bristol-communal-modular/state-variable-filter/fixes.md

# Fixes

## Rev 01

* On all four of the filter output jacks, remove the switch for the tip connection. Otherwise the outputs connect to ground through the 330r resistor.
* Add a 47k resistor to ground and the PING jack
* Add two 5pF ceramic C0G capacitors, one in parallel with R28 and one in parallel with R29.
