bristol-communal-modular/state-variable-filter/design/2164-filter.pdf

# Ouroboros 2164 Gain Cell Filter

Guy John
guy@rumblesan.com

December 13, 2025

## 1 Introduction

Analysis of the Ouroboros filter. Heavily based on the Mutable Instruments Blades filter with influences from the Serge VCFQ as well. Much of this analysis is pulled from the SSM2164 SVF Analysis by Emilie Gillet and then just somewhat modified.

1

### 1.1 Notations

Rm is the value of the resistor at the input of the mixer section.

Ri

is the value of the resistors in the input to the 2164 integrator cells.

Rhp is the value of the resistor through which the HP output is fed back into the input mixer.

Rbp is the value of the resistor through which the BP output is fed back into the input mixer.

Rlp is the value of the resistor through which the LP output is fed back into the input mixer.

Rq is the value of the resistor at the input of the gain cell feeding the BP output back to control the Q of the filter.

C is the value of the integrators’ capacitors.

vcv is the cutoff frequency control voltage.

vq is the resonance control voltage.

vi

is the input voltage.

vhp(s), vbp(s) and vlp(s) are the high-pass, band-pass and low-pass output voltages.

For reference, the standard second-order filter transfer functions are:

Hlp(s) = | 1
τ

2s

| 2 +
| 1 q
τs + 1
Hbp(s) = | 1

q
| τ s + qτs + 1
Hhp(s) = | 1

1
τ

2s

| 2 +

1
| qτ s + 1

Where τ =

1
2πC

2

1.2 2164 Integrator Cell

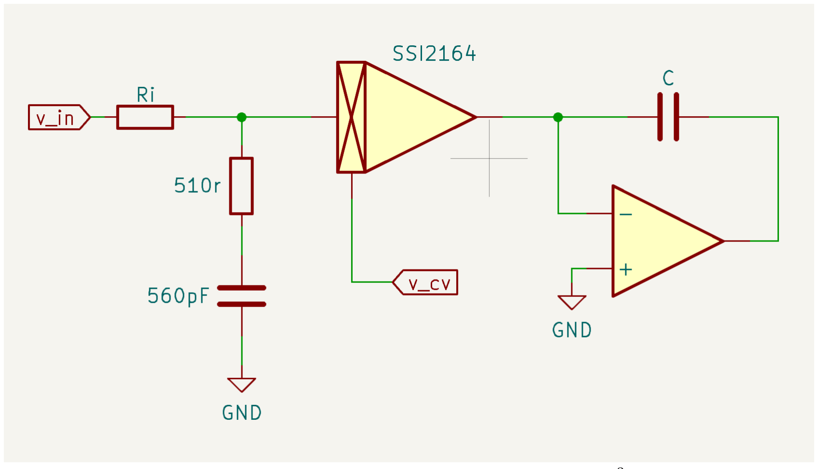
[picture p4: figure]

The current gain of a 2164 gain cell is iout = iin10⁻ ³
2

vcv . The transfer
function of the integrator cell α can then be calculated.

iin =

vin
Ri

iout =

vin
Ri

10⁻ ³
2

vcv

vout = −

iout
Cs

vout = −

vin
Ri

10⁻ ³
2

vcv

Cs

= −

vin10⁻ ³
2

vcv
CsRi
α(s) = vout

vin

= −

1
CsRi

10⁻ ³
2

vcv

3

### 1.3 Resonance VCA

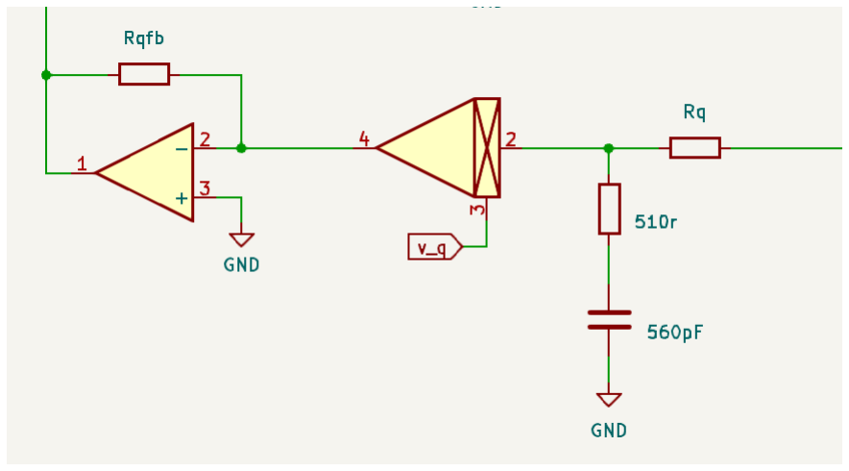
[picture p5: figure]

The transfer function of the resonance feedback VCA β can then be calculated.

iin =

vin
Rq

iout =

vin
Rq

10⁻ ³
2

vq

vout = −ioutRqf b

vout = −

vinRqf b
Rq

10⁻ ³
2

vq

β(s) = vout

vin

= −

Rqf b
Rq

10⁻ ³
2

vq

4

### 1.4 Filter


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
### 1.4.1 High-pass

vhp(s)

Rhp

= −

vi(s)
Ri

−

βvbp(s)

Rbp

−

vlp(s)

Rlp
vhp(s)

Rhp

= −

vi(s)
Ri

−

βα(s)vhp(s)

Rbp

−

α

2
(s)vhp(s)

Rlp
vi(s)
Ri

= −

vhp(s)

Rhp

−

βα(s)vhp(s)

Rbp

−

α

2
(s)vhp(s)

Rlp
vi(s)
Ri

= −vhp(s)( 1

Rhp

+

βα(s)

Rbp

+

α

2
(s)

Rlp

)

vi(s)
vhp(s)

= −Ri(

1

Rhp

+

βα(s)

Rbp

+

α

2
(s)

Rlp

)

Hhp(s) = vhp(s)
vi(s)

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
βα(s)

Rbp

+

α²(s)

Rlp

)

Rhp = Rbp = Rlp = R

= −

1
Ri

1
(

1
R +

βα(s)
R +

α²(s)
R

)

= −

R
Ri
1 + βα(s) + α²(s)

G =

R
Ri

is the pass-band gain.

6

### 1.4.2 Low-Pass

Hlp(s) = vlp(s)
vi(s)

=

vhp(s)
vi(s)

α

2
(s)

= −

R
Ri
1
α²(s) + β

1
α(s) + 1

= −

R
Ri
1
α²(s) + β

1
α(s) + 1

= −

R
Ri
1
(− 1
CsRi

10⁻ ³
2

vcv )

2 + (−

Rqfb
Rq

10⁻ ³
2

vq )

1
− 1
CsRi

10⁻ ³
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
CsRi

10⁻ ³
2

vcv )

2 + ( Rqfb
Rq

10⁻ ³
2

vq )

1

1
CsRi

10⁻ ³
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
10⁻ ³
2

vcv )

2 + ( Rqfb
Rq

10⁻ ³
2

vq )

1

1
s

1
CRi

10⁻ ³
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
10⁻ ³
2

vcv )

2 + ( Rqfb
Rq

10⁻ ³
2

vq )

1

1
s

1
CRi

10⁻ ³
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
10⁻ ³
2

vcv )

2 + ( Rqfb
Rq

10⁻ ³
2

vq )

s

1
CRi

10⁻ ³
2

vcv

+ 1

By comparing with the standard form of a second order filter transfer function we can work out the following.

Pass-band gain, −

R
Ri

Cutoff frequency, f =

1
2πRiC

10⁻ ³
2

vcv

Quality factor, Rq

Rqfb

10 ³
2

vq

### 1.5 Calculating cutoff frequencies

Given the calculation for frequency, and picking some standard values we can calculate cutoff for different icv values.

Ri

is 33k

C is 220pF

7

f =

1
2π ∗ 33000 ∗ 220 ∗ 10⁻¹² 10⁻ ³
2
vcv | (1)

for vcv of 0V f = 21922Hz

for vcv of 0.25V f = 9244Hz

for vcv of 0.5V f = 3898Hz

for vcv of 1V f = 693Hz

for vcv of 2V f = 21Hz

for vcv of 3V f = 0.69Hz

### 1.6 Calculating resonance

A quality factor of 1/2 gives no resonance, whilst the resonance (and likelihood of self oscillating) increases as Q goes to infinity.
Assuming that Rq

Rqfb

= 1/2

Rq is 15k

Rqf b is 30k

q =

15000
30000

10

3/2 vq
(2)

for vq of 0.0V q = 0.5

for vq of 0.25V q = 1.18

for vq of 0.5V q = 2.811

for vq of 1V q = 15.8

for vq of 2V q = 500

8
