bristol-communal-modular/state-variable-filter/kicad/state-variable-filter.kicad_pcb

## KiCad design kicad/state-variable-filter.kicad_pcb (2026-03-02)

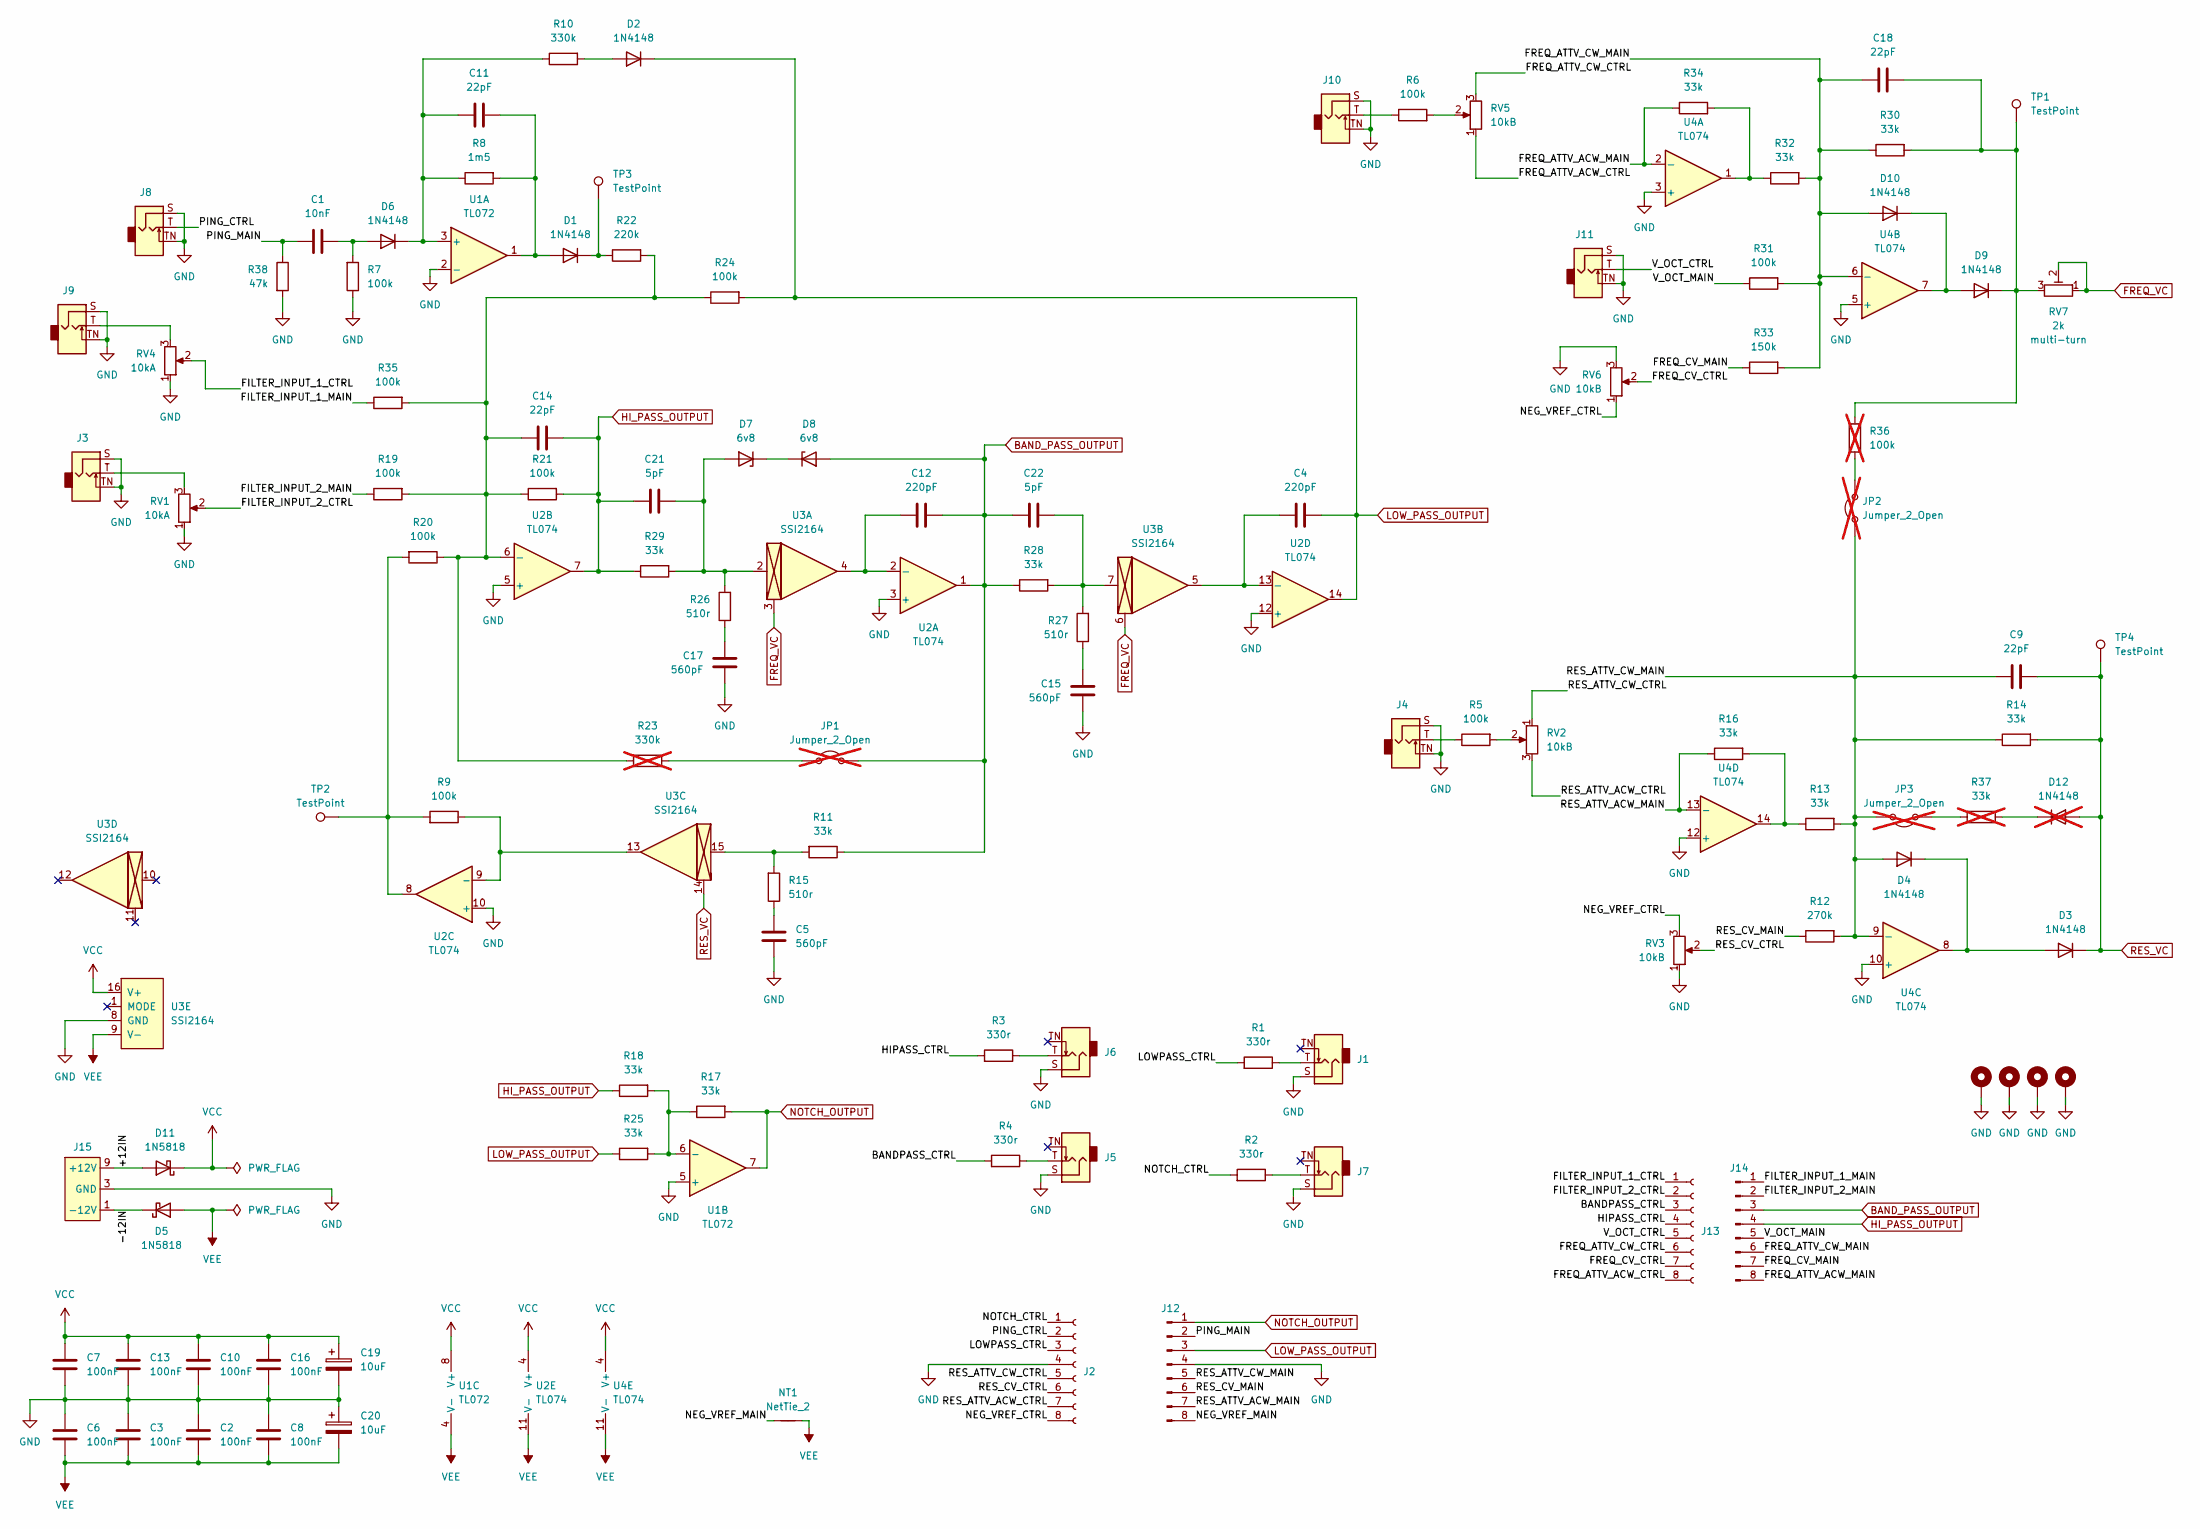
[picture p6: schematic state-variable-filter.kicad_sch, 2164 State Variable Filter]

Parts:
C1: 10nF; C_Rect_L7.0mm_W2.5mm_P5.00mm; Tolerance 5%
C2, C3, C6, C7, C8, C10, C13, C16: 100nF; C_Rect_L7.0mm_W2.5mm_P5.00mm; Tolerance 5%
C4, C12: 220pF; C_Rect_L7.0mm_W4.5mm_P5.00mm; Tolerance 1%
C5, C15, C17: 560pF; C_Rect_L7.0mm_W2.5mm_P5.00mm; Tolerance 5%
C9, C11, C14, C18: 22pF; C_Rect_L7.0mm_W2.5mm_P5.00mm; Tolerance 5%
C19, C20: 10uF; CP_Radial_D5.0mm_P2.00mm
C21, C22: 5pF; C_Rect_L7.0mm_W2.5mm_P5.00mm; Tolerance 5%
D1, D2, D3, D4, D6, D9, D10: 1N4148; D_DO-35_SOD27_P7.62mm_Horizontal
D5, D11: 1N5818; D_DO-41_SOD81_P10.16mm_Horizontal
D7, D8: 6v8; D_DO-35_SOD27_P7.62mm_Horizontal
D12: 1N4148; D_DO-35_SOD27_P7.62mm_Horizontal; not fitted
H1, H2, H3, H4: MountingHole_Pad; MountingHole_3.2mm_M3_DIN965_Pad
J1, J3, J4, J5, J6, J7, J8, J9, J10, J11: AudioJack2_SwitchT; Jack_3.5mm_QingPu_WQP-PJ398SM_Vertical
J2, J13: Conn_01x08_Socket; PinSocket_1x08_P2.54mm_Vertical
J12, J14: Conn_01x08_Pin; PinHeader_1x08_P2.54mm_Vertical
J15: Conn_02x05_Odd_Even; Eurorack_Power_IDC-Header_2x05_P2.54mm_Vertical
JP1, JP2, JP3: Jumper_2_Open; PinHeader_1x02_P2.54mm_Vertical; not fitted
NT1: NetTie_2; NetTie-2_SMD_Pad0.5mm
R1, R2, R3, R4: 330r; R_Axial_DIN0207_L6.3mm_D2.5mm_P10.16mm_Horizontal; Tolerance 1%
R5, R6, R7, R9, R19, R20, R21, R24, R31, R35: 100k; R_Axial_DIN0207_L6.3mm_D2.5mm_P10.16mm_Horizontal; Tolerance 1%
R8: 1m5; R_Axial_DIN0207_L6.3mm_D2.5mm_P10.16mm_Horizontal; Tolerance 1%
R10: 330k; R_Axial_DIN0207_L6.3mm_D2.5mm_P10.16mm_Horizontal; Tolerance 1%
R11, R13, R14, R16, R17, R18, R25, R28, R29, R30, R32, R34: 33k; R_Axial_DIN0207_L6.3mm_D2.5mm_P10.16mm_Horizontal; Tolerance 1%
R12: 270k; R_Axial_DIN0207_L6.3mm_D2.5mm_P10.16mm_Horizontal; Tolerance 1%
R15, R26, R27: 510r; R_Axial_DIN0207_L6.3mm_D2.5mm_P10.16mm_Horizontal; Tolerance 1%
R22: 220k; R_Axial_DIN0207_L6.3mm_D2.5mm_P10.16mm_Horizontal; Tolerance 1%
R23: 330k; R_Axial_DIN0207_L6.3mm_D2.5mm_P10.16mm_Horizontal; Tolerance 1%; not fitted
R33: 150k; R_Axial_DIN0207_L6.3mm_D2.5mm_P10.16mm_Horizontal; Tolerance 1%
R36: 100k; R_Axial_DIN0207_L6.3mm_D2.5mm_P10.16mm_Horizontal; Tolerance 1%; not fitted
R37: 33k; R_Axial_DIN0207_L6.3mm_D2.5mm_P10.16mm_Horizontal; Tolerance 1%; not fitted
R38: 47k; R_Axial_DIN0207_L6.3mm_D2.5mm_P10.16mm_Horizontal; Tolerance 1%
RV1, RV4: 10kA; Potentiometer_Alpha_RD901F-40-00D_Single_Vertical
RV2, RV3, RV5, RV6: 10kB; Potentiometer_Alpha_RD901F-40-00D_Single_Vertical
RV7: 2k; Potentiometer_Vishay_T93YB_Vertical
TP1, TP2, TP3, TP4: TestPoint; TestPoint_Loop_D2.50mm_Drill1.0mm_LowProfile
U1: TL072; DIP-8_W7.62mm_Socket
U2, U4: TL074; DIP-14_W7.62mm_Socket
U3: SSI2164; DIP-16_W7.62mm_Socket

Connections:
/+12IN: D11.2 (A), J15.9 (+12V), J15.10 (+12V)
/-12IN: D5.1 (K), J15.1 (-12V), J15.2 (-12V)
/BANDPASS_CTRL: J13.3, R4.2
/FILTER_INPUT_1_CTRL: J13.1, RV4.2
/FILTER_INPUT_1_MAIN: J14.1, R35.2
/FILTER_INPUT_2_CTRL: J13.2, RV1.2
/FILTER_INPUT_2_MAIN: J14.2, R19.2
/FREQ_ATTV_ACW_CTRL: J13.8, RV5.1
/FREQ_ATTV_ACW_MAIN: J14.8, R34.2, U4.2 (-)
/FREQ_ATTV_CW_CTRL: J13.6, RV5.3
/FREQ_ATTV_CW_MAIN: C18.1, D10.2 (A), J14.6, R30.2, R31.1, R32.1, R33.1, U4.6 (-)
/FREQ_CV_CTRL: J13.7, RV6.2
/FREQ_CV_MAIN: J14.7, R33.2
/HIPASS_CTRL: J13.4, R3.2
/LOWPASS_CTRL: J2.3, R1.2
/NEG_VREF_CTRL: J2.8, RV3.3, RV6.1
/NEG_VREF_MAIN: J12.8, NT1.1
/NOTCH_CTRL: J2.1, R2.2
/PING_CTRL: J2.2, J8.T
/PING_MAIN: C1.1, J12.2, R38.2
/RES_ATTV_ACW_CTRL: J2.7, RV2.3
/RES_ATTV_ACW_MAIN: J12.7, R16.2, U4.13 (-)
/RES_ATTV_CW_CTRL: J2.5, RV2.1
/RES_ATTV_CW_MAIN: C9.1, D4.2 (A), J12.5, JP2.1 (A), JP3.2 (B), R12.1, R13.1, R14.2, U4.9 (-)
/RES_CV_CTRL: J2.6, RV3.2
/RES_CV_MAIN: J12.6, R12.2
/V_OCT_CTRL: J11.T, J13.5
/V_OCT_MAIN: J14.5, R31.2
BAND_PASS_OUTPUT: C12.2, C22.1, D8.2 (A), J14.3, JP1.2 (B), R11.2, R28.2, U2.1
FREQ_VC: RV7.1, RV7.2, U3.3, U3.6
GND: C2.1, C3.1, C5.2, C6.1, C7.2, C8.1, C10.2, C13.2, C15.2, C16.2, C17.2, C19.2, C20.1, H1.1, H2.1, H3.1, H4.1, J1.S, J2.4, J3.S, J3.TN, J4.S, J4.TN, J5.S, J6.S, J7.S, J8.S, J8.TN, J9.S, J9.TN, J10.S, J10.TN, J11.S, J11.TN, J12.4, J15.3 (GND), J15.4 (GND), J15.5 (GND), J15.6 (GND), J15.7 (GND), J15.8 (GND), R7.2, R38.1, RV1.1, RV3.1, RV4.1, RV6.3, U1.2 (-), U1.5 (+), U2.3 (+), U2.5 (+), U2.10 (+), U2.12 (+), U3.8 (GND), U4.3 (+), U4.5 (+), U4.10 (+), U4.12 (+)
HI_PASS_OUTPUT: C14.2, C21.1, J14.4, R18.2, R21.1, R29.2, U2.7
LOW_PASS_OUTPUT: C4.2, D2.1 (K), J12.3, R24.1, R25.2, U2.14
NOTCH_OUTPUT: J12.1, R17.1, U1.7
unnamed: C5.1, R15.2
unnamed: C15.1, R27.2
unnamed: C17.1, R26.2
unnamed: C22.2, R27.1, R28.1, U3.7
unnamed: C11.2, D1.2 (A), R8.1, U1.1
unnamed: D1.1 (K), R22.2, TP3.1
unnamed: D2.2 (A), R10.1
unnamed: D3.2 (A), D4.1 (K), U4.8
unnamed: C1.2, D6.2 (A), R7.1
unnamed: C11.1, D6.1 (K), R8.2, R10.2, U1.3 (+)
unnamed: C21.2, D7.2 (A), R26.1, R29.1, U3.2
unnamed: D7.1 (K), D8.1 (K)
unnamed: C18.2, D9.1 (K), R30.1, R36.1, RV7.3, TP1.1
unnamed: D9.2 (A), D10.1 (K), U4.7
unnamed: D12.1 (K), R37.1
unnamed: J1.T, R1.1
unnamed: J3.T, RV1.3
unnamed: J4.T, R5.2
unnamed: J5.T, R4.1
unnamed: J6.T, R3.1
unnamed: J7.T, R2.1
unnamed: J9.T, RV4.3
unnamed: J10.T, R6.2
unnamed: JP1.1 (A), R23.1
unnamed: JP2.2 (B), R36.2
unnamed: JP3.1 (A), R37.2
unnamed: R5.1, RV2.2
unnamed: R6.1, RV5.2
unnamed: R11.1, R15.1, U3.15
unnamed: R13.2, R16.1, U4.14
unnamed: R9.1, R20.1, TP2.1, U2.8
unnamed: R32.2, R34.1, U4.1
unnamed: R17.2, R18.1, R25.1, U1.6 (-)
unnamed: C12.1, U2.2 (-), U3.4
unnamed: C14.1, R19.1, R20.2, R21.2, R22.1, R23.2, R24.2, R35.1, U2.6 (-)
unnamed: R9.2, U2.9 (-), U3.13
unnamed: C4.1, U2.13 (-), U3.5
RES_VC: C9.2, D3.1 (K), D12.2 (A), R14.1, TP4.1, U3.14
VCC: C7.1, C10.1, C13.1, C16.1, C19.1, D11.1 (K), U1.8 (V+), U2.4 (V+), U3.16 (V+), U4.4 (V+)
VEE: C2.2, C3.2, C6.2, C8.2, C20.2, D5.2 (A), NT1.2, U1.4 (V-), U2.11 (V-), U3.9 (V-), U4.11 (V-)

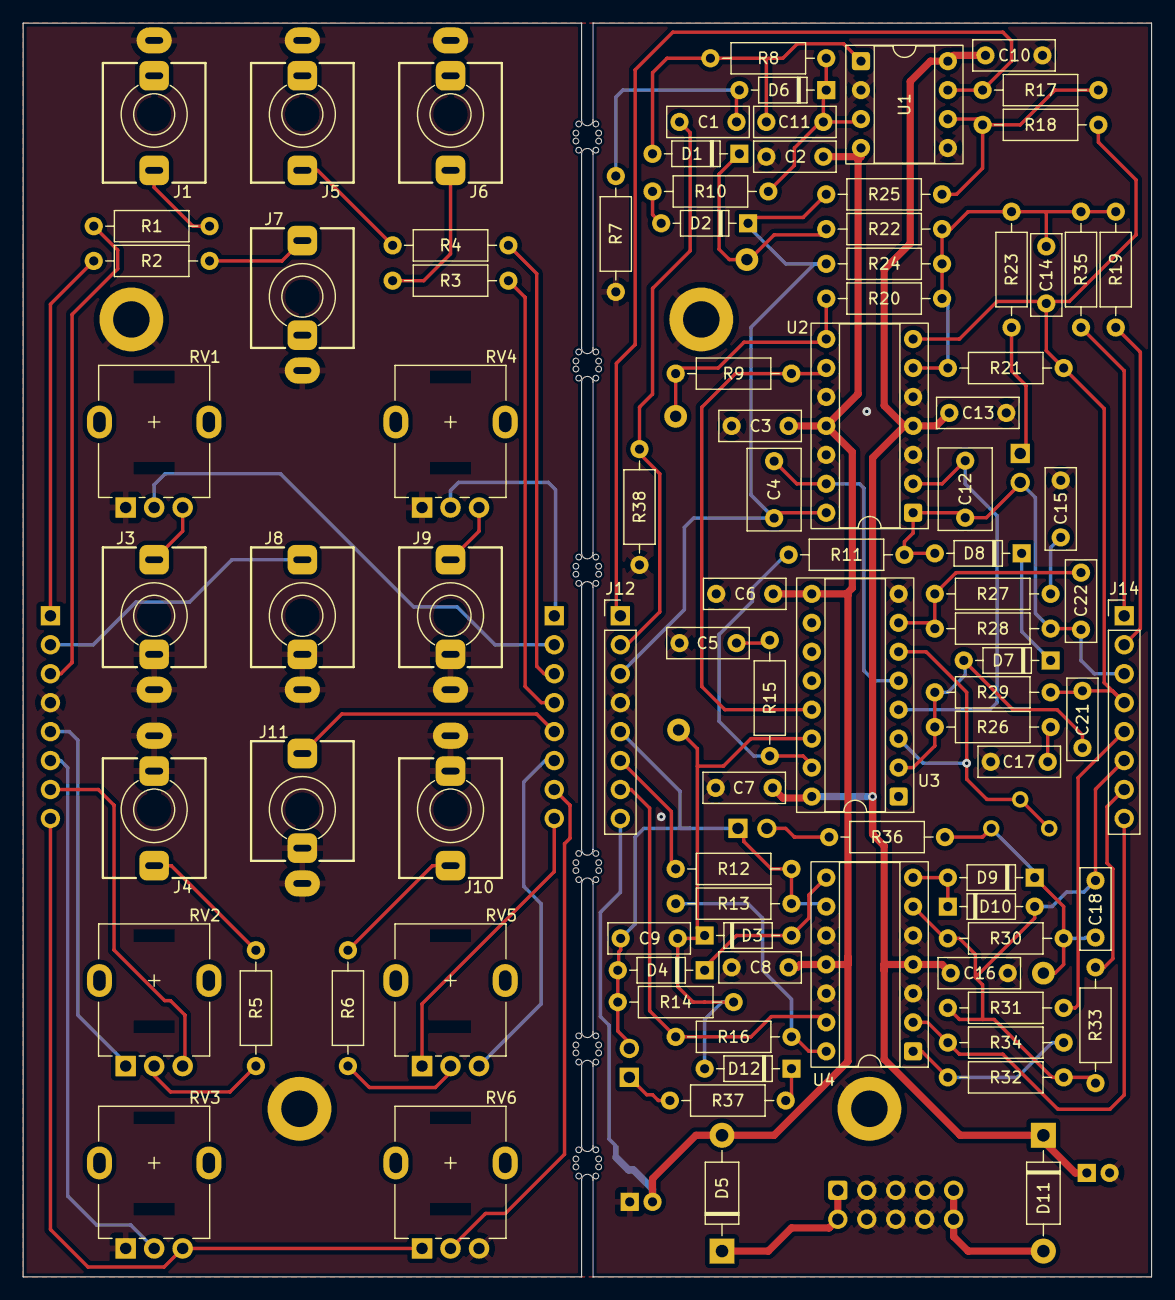
[picture p7: board state-variable-filter.kicad_pcb from above]

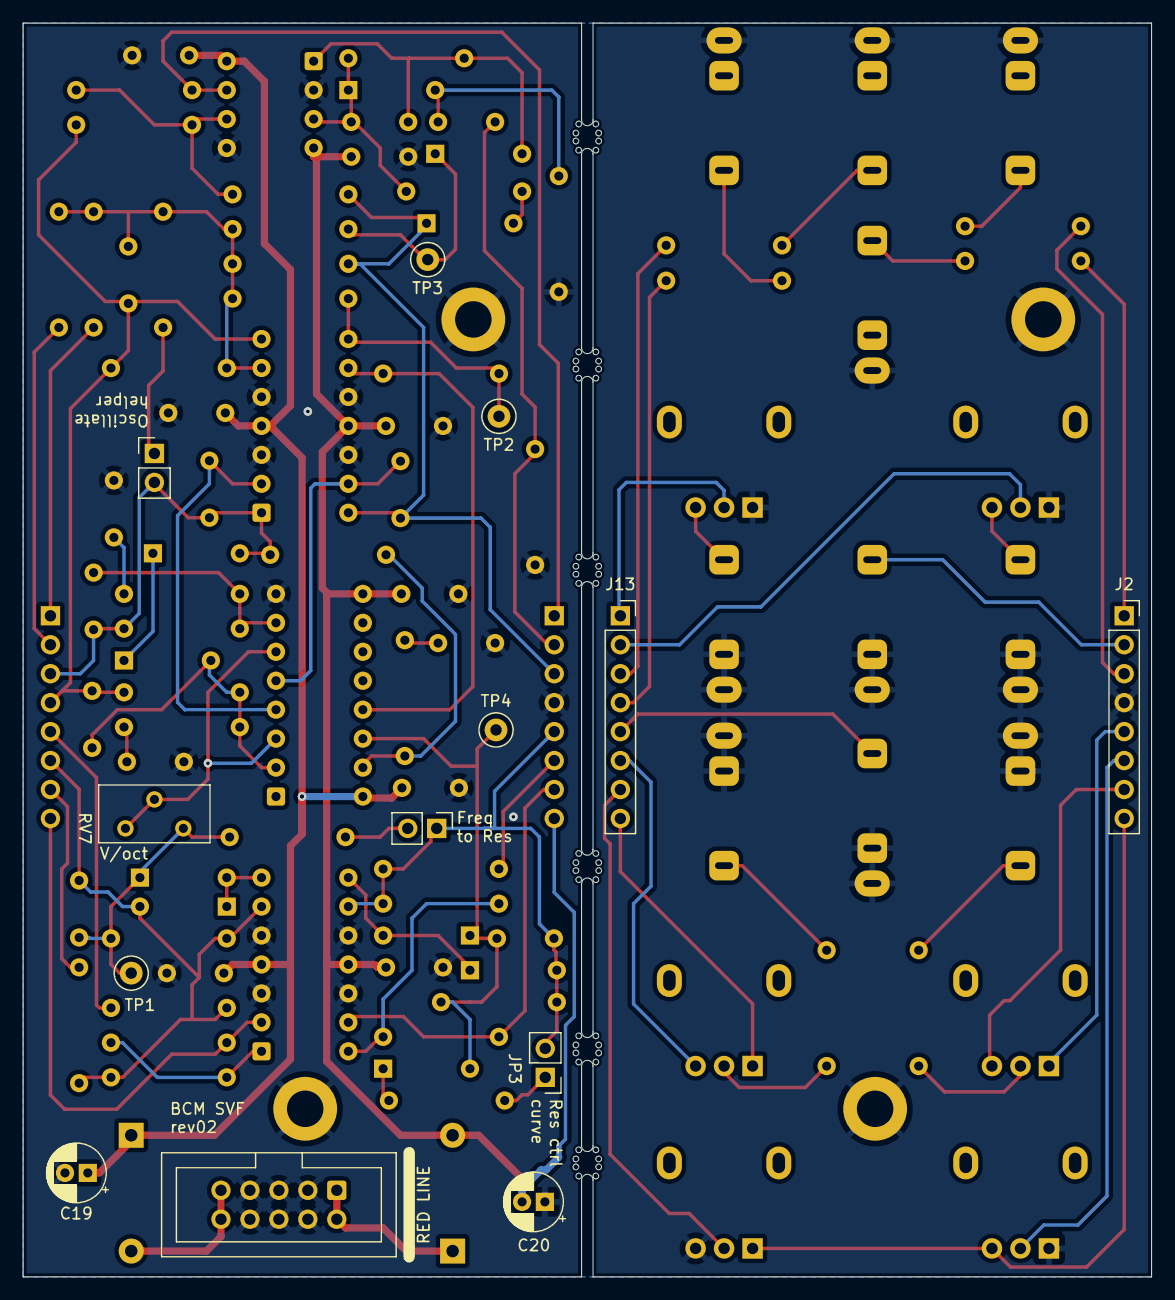
[picture p8: board state-variable-filter.kicad_pcb from below]

Board: 2 copper layers, 99.0 x 110.0 mm, 116 parts (14 on the bottom side), 74 nets.

Other parts of the board:
mouse-bite-1mm-slot, mouse-bite-1mm-slot#2, mouse-bite-1mm-slot#3, mouse-bite-1mm-slot#4, mouse-bite-1mm-slot#5, mouse-bite-1mm-slot#6: VAL**; mouse-bite-1mm-slot
