bristol-communal-modular/state-variable-filter/design/schematics/circuits.kicad_sch

## KiCad design design/schematics/circuits.kicad_sch (2025-12-15)

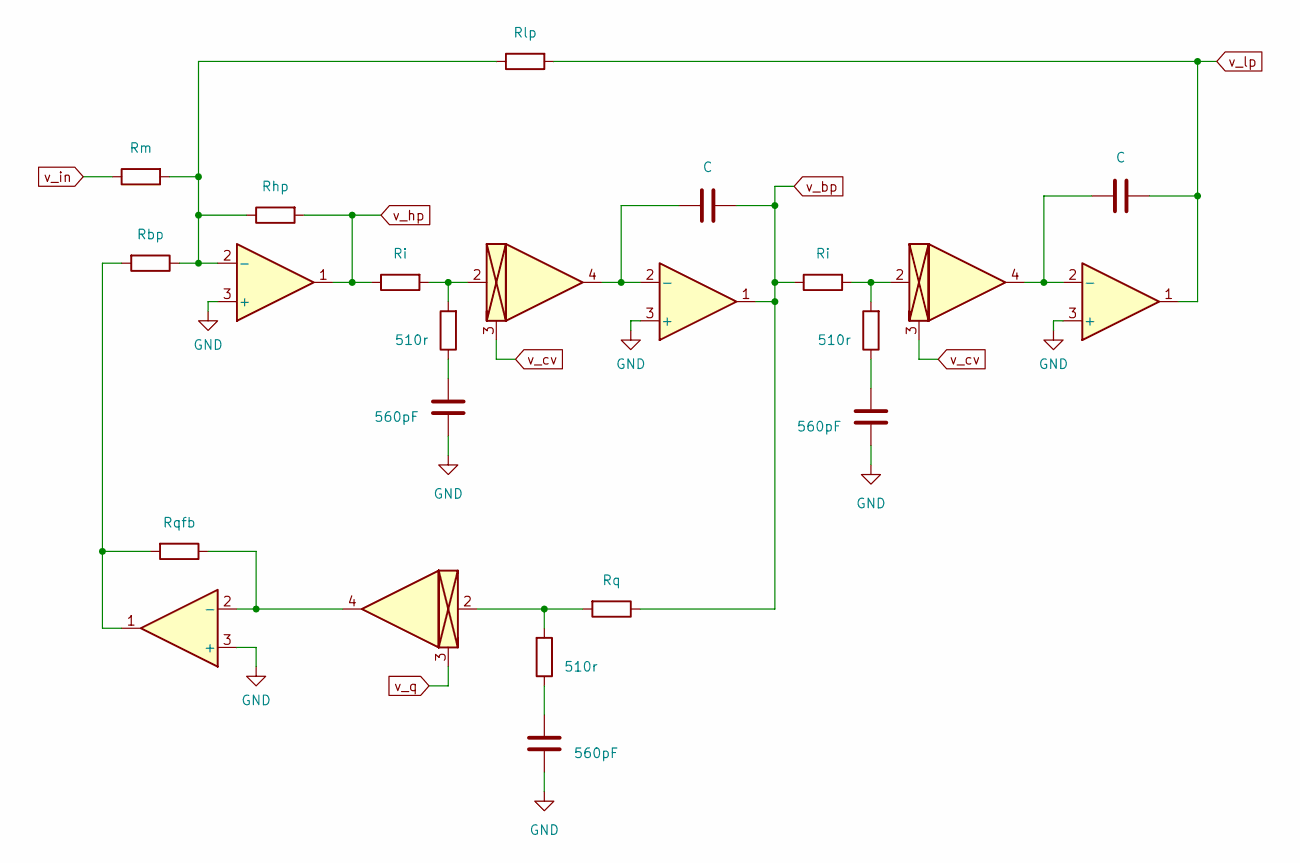
[picture p9: schematic circuits.kicad_sch]

Parts:
C28, C29, C31: 560pF; C_Rect_L7.0mm_W2.5mm_P5.00mm; Tolerance 5%
C30, C32: C; C_Rect_L7.0mm_W2.5mm_P5.00mm; Tolerance 1%
R17: Rm; R_Axial_DIN0207_L6.3mm_D2.5mm_P10.16mm_Horizontal; Tolerance 1%
R18: Rbp; R_Axial_DIN0207_L6.3mm_D2.5mm_P10.16mm_Horizontal; Tolerance 1%
R19: Rqfb; R_Axial_DIN0207_L6.3mm_D2.5mm_P10.16mm_Horizontal; Tolerance 1%
R23: Rhp; R_Axial_DIN0207_L6.3mm_D2.5mm_P10.16mm_Horizontal; Tolerance 1%
R55, R60: Ri; R_Axial_DIN0207_L6.3mm_D2.5mm_P10.16mm_Horizontal; Tolerance 1%
R56, R58, R62: 510r; R_Axial_DIN0207_L6.3mm_D2.5mm_P10.16mm_Horizontal; Tolerance 1%
R57: Rlp; R_Axial_DIN0207_L6.3mm_D2.5mm_P10.16mm_Horizontal; Tolerance 1%
R59: Rq; R_Axial_DIN0207_L6.3mm_D2.5mm_P10.16mm_Horizontal; Tolerance 1%
U10, U12: OPA1678
U13: SSI2164

Connections:
GND: C28.2, C29.2, C31.2, U10.3 (+), U12.3 (+)
unnamed: C28.1, R56.2
unnamed: C29.1, R58.2
unnamed: C30.1, U12.2 (-), U13.4
unnamed: C31.1, R62.2
unnamed: C32.1, U10.2 (-), U13.4
unnamed: R17.1, R18.2, R23.2, R57.2, U12.2 (-)
unnamed: R18.1, R19.1, U10.1
unnamed: R19.2, U10.2 (-), U13.4
unnamed: R55.1, R56.1, U13.2
unnamed: R58.1, R59.1, U13.2
unnamed: R60.1, R62.1, U13.2
v_bp: C30.2, R59.2, R60.2, U12.1
v_cv: U13.3
v_hp: R23.1, R55.2, U12.1
v_in: R17.2
v_lp: C32.2, R57.1, U10.1
v_q: U13.3
