bristol-communal-modular/state-variable-filter/(commit log)

2025-12-06 Moving kicad files into subfolder
    [state-variable-filter.kicad_pcb, state-variable-filter.kicad_sch]
2025-12-15 Updating hardware design
    [state-variable-filter.kicad_pcb, state-variable-filter.kicad_sch]
2025-12-15 Adding filter design docs
    [circuits.kicad_sch]
2025-12-24 Updating design
    * Adding resonance control curve jumper
    * improving layout
    [state-variable-filter.kicad_pcb, state-variable-filter.kicad_sch]
2026-01-03 Fixing a couple issues with schematic and layout
    [state-variable-filter.kicad_pcb, state-variable-filter.kicad_sch]
2026-01-03 Adding panel PCB
    [state-variable-filter-faceplate.kicad_pcb]
2026-01-03 Plotting gerbers
    [state-variable-filter-B_Cu.gbl, state-variable-filter-B_Mask.gbs, state-variable-filter-B_Silkscreen.gbo, state-variable-filter-Edge_Cuts.gm1, state-variable-filter-F_Cu.gtl, state-variable-filter-F_Mask.gts, state-variable-filter-F_Silkscreen.gto, state-variable-filter-faceplate-B_Cu.gbl]
2026-02-24 minor tweaks
    [state-variable-filter.kicad_pcb]
2026-02-24 Adding BOM
2026-02-26 Fixing minor BOM value issues
    [state-variable-filter.kicad_pcb, state-variable-filter.kicad_sch]
2026-03-02 Updating schematic after value tweaks
    and regenerating BOMs
    [state-variable-filter.kicad_pcb, state-variable-filter.kicad_sch]
2026-03-02 Updating with rev02 fixes
    [state-variable-filter.kicad_pcb, state-variable-filter.kicad_sch]
2026-03-02 Regenerating BOMs
    [state-variable-filter-bom.csv]
2026-03-02 Regenerating gerbers for rev02
    [state-variable-filter-B_Cu.gbl, state-variable-filter-B_Mask.gbs, state-variable-filter-B_Silkscreen.gbo, state-variable-filter-Edge_Cuts.gm1, state-variable-filter-F_Cu.gtl, state-variable-filter-F_Mask.gts, state-variable-filter-F_Silkscreen.gto, state-variable-filter-job.gbrjob]
