bristol-communal-modular/state-variable-filter/(notices)

Notices in the files:
design/schematics/circuits.kicad_sch:
creativecommons.org/licenses/by/4.0
License: CC BY 4.0
